SaintGimp/WirelessTemperature/README.md

# Wireless temperature sensors

This project is documented via a series of posts on my blog, [starting here](https://saintgimp.org/2016/07/10/building-a-wireless-temperature-sensor-network-part-1/).
