SaintGimp/WirelessTemperature/(list of files, cad)

Other CAD files:
base/BaseStationCase.f3z
