SaintGimp/WirelessTemperature/board/WirelessTempSensor.brd

## EAGLE design board/WirelessTempSensor.brd (2018-08-28)

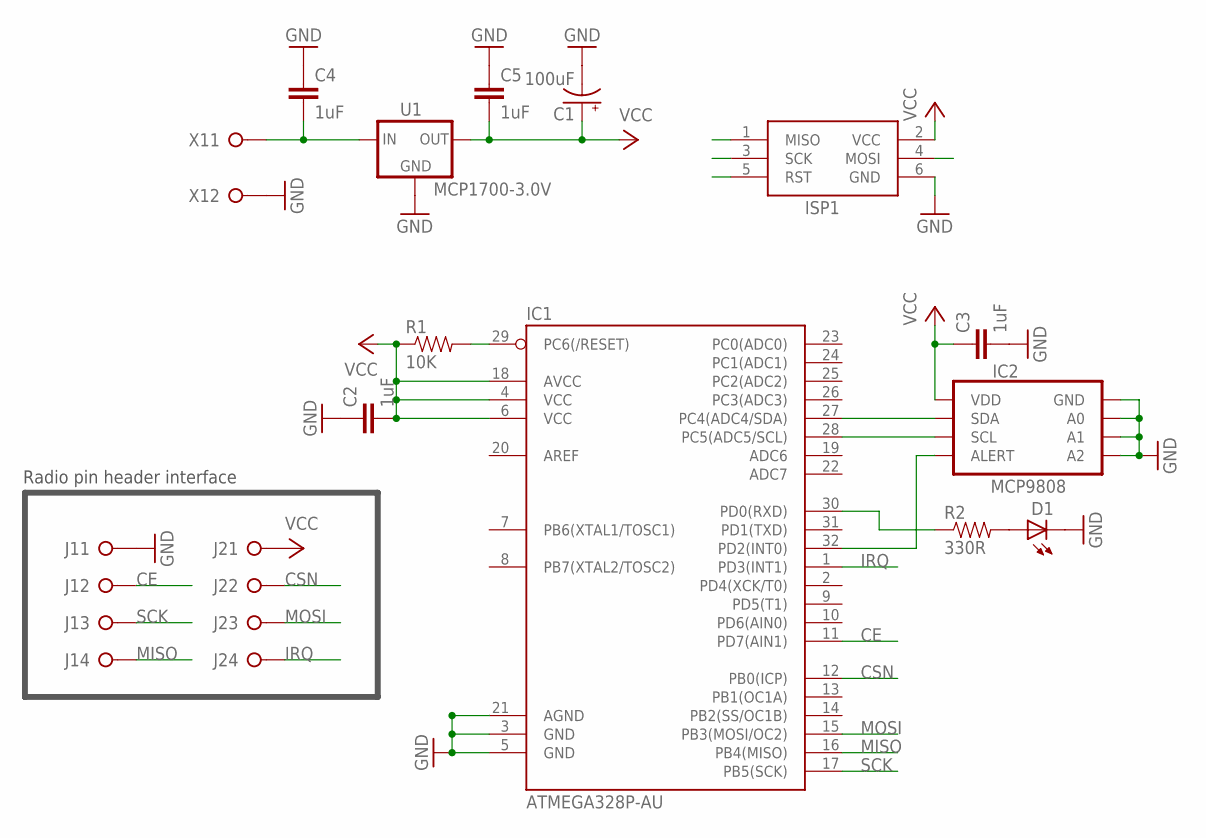
[picture p1: schematic WirelessTempSensor.sch]

Parts:
C1: 100uF; CAP-POL-2.5-6
C2, C3, C4, C5: 1uF; CAPACITOR-0805
D1: LED-0805
IC1: ATMEGA328P-AU; QFP32-08
IC2: MCP9808; MSOP8-0.65-3X3MM
ISP1: ICSP-HEADER-6; ICSP-HEADER
J1, J2: PINHD-1X4; 1X04
R1: 10K; RESISTOR-0805
R2: 330R; RESISTOR-0805
U1: MCP1700-3.0V; SOT-23-3
X1: SCREW-TERM-2

Connections:
ALERT: IC1.32 (PD2(INT0)), IC2.3 (ALERT)
CE: IC1.11 (PD7(AIN1)), J1.2
CSN: IC1.12 (PB0(ICP)), J2.2
GND: C1.-, C2.1, C3.2, C4.1, C5.1, D1.2 (C), IC1.3 (GND), IC1.5 (GND), IC1.21 (AGND), IC2.4 (GND), IC2.5 (A2), IC2.6 (A1), IC2.7 (A0), ISP1.6 (GND), J1.1, U1.1 (GND), X1.2
IRQ: IC1.1 (PD3(INT1)), J2.4
MISO: IC1.16 (PB4(MISO)), ISP1.1 (MISO), J1.4
MOSI: IC1.15 (PB3(MOSI/OC2)), ISP1.4 (MOSI), J2.3
unnamed: IC1.30 (PD0(RXD)), R2.1
unnamed: D1.1 (A), R2.2
RST: IC1.29 (PC6(/RESET)), ISP1.5 (RST), R1.2
SCK: IC1.17 (PB5(SCK)), ISP1.3 (SCK), J1.3
SCL: IC1.28 (PC5(ADC5/SCL)), IC2.2 (SCL)
SDA: IC1.27 (PC4(ADC4/SDA)), IC2.1 (SDA)
VCC: C1.+, C2.2, C3.1, C5.2, IC1.4 (VCC), IC1.6 (VCC), IC1.18 (AVCC), IC2.8 (VDD), ISP1.2 (VCC), J2.1, R1.1, U1.2 (OUT)
VIN: C4.2, U1.3 (IN), X1.1

Notes on the sheet:
Radio pin header interface

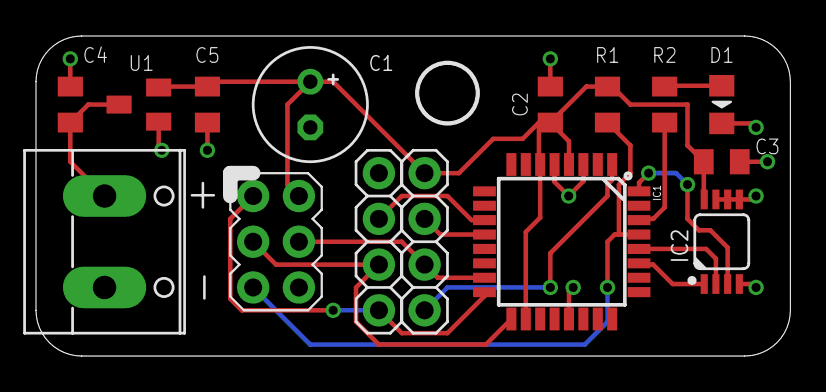
[picture p2: board WirelessTempSensor.brd from above]

Board: 2 copper layers, 41.9 x 17.8 mm, 16 parts (0 on the bottom side), 15 nets.

Other parts of the board:
U$3: MOUNTING-HOLE-3.2MM
