SaintGimp/WirelessTemperature/(commit log)

2016-03-07 Initial sensor code
2016-03-24 Add Eagle files for sensor board
    [WirelessTempSensor.brd, WirelessTempSensor.sch]
2016-07-11 Clean up schematic a bit
    [WirelessTempSensor.sch]
2018-02-03 Add Fusion 360 export of base station case
    [BaseStationCase.f3z]
2018-02-03 Add BOM for sensor board
2018-05-14 Change extended fuse to match new AVRDude behavior
2018-08-28 Update BOM with more common value for R2
    [WirelessTempSensor.brd, WirelessTempSensor.sch]
2021-10-01 Attempt to fix app hang
    [base.ino]
